freetronics/OLEDSHIELD/OLEDShield.sch

## KiCad design OLEDShield.sch (2013-09-17)

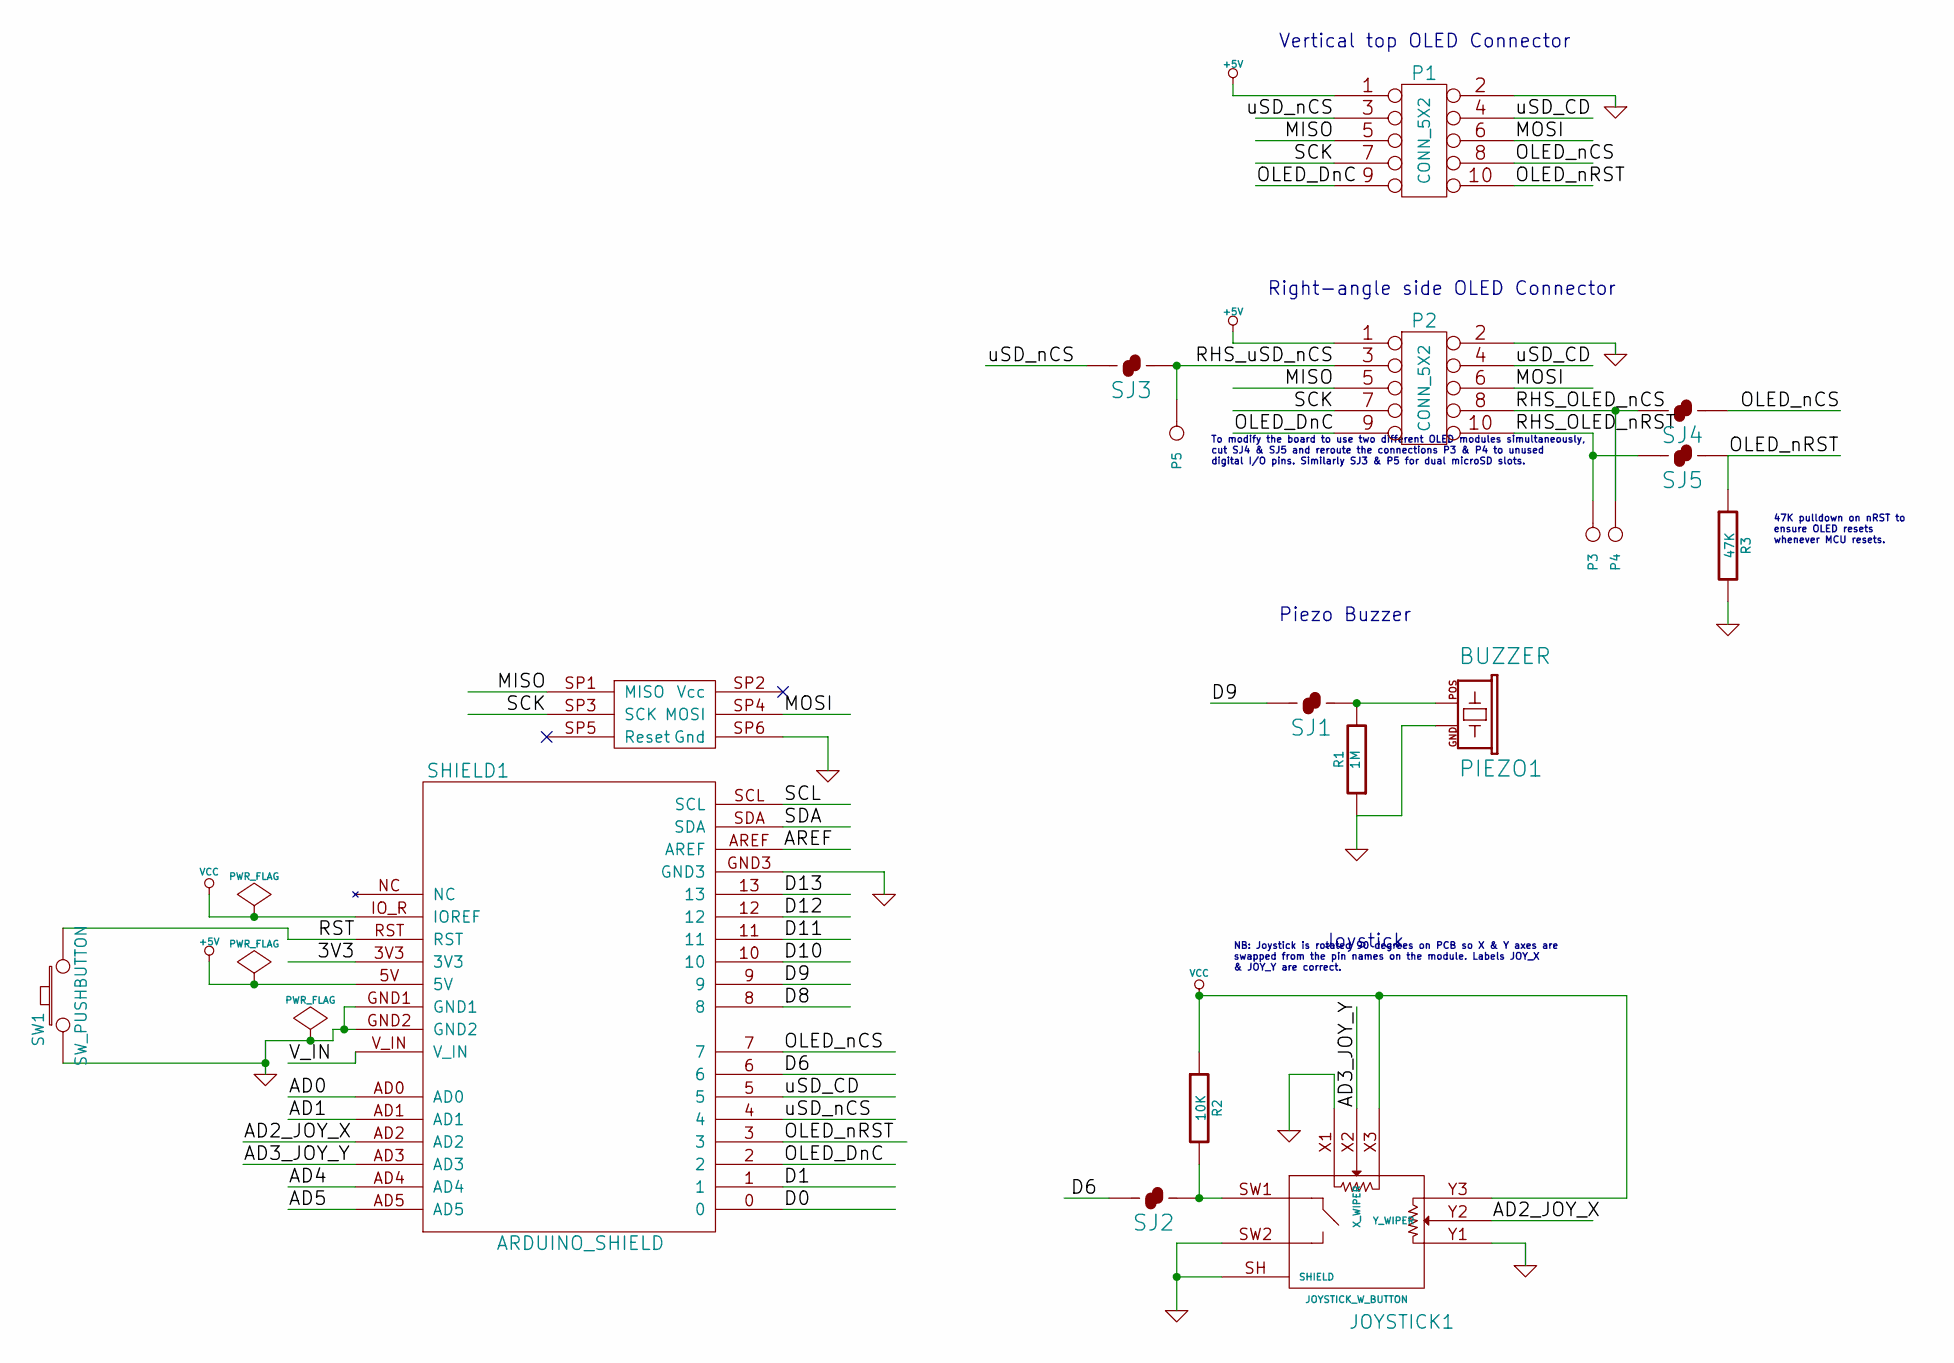
[picture p1: schematic OLEDShield.sch]

Parts:
JOYSTICK1: JOYSTICK_W_BUTTON
P1, P2: CONN_5X2
P3, P4, P5: CONN_1
PIEZO1: BUZZER
R1: 1M
R2: 10K
R3: 47K
SHIELD1: ARDUINO_SHIELD
SJ1, SJ2, SJ3, SJ4, SJ5: SJ
SW1: SW_PUSHBUTTON

Connections:
3V3: SHIELD1.3V3
+5V: P1.1, P2.1, SHIELD1.5V
AD0: SHIELD1.AD0
AD1: SHIELD1.AD1
AD2_JOY_X: JOYSTICK1.Y2 (Y_WIPER), SHIELD1.AD2
AD3_JOY_Y: JOYSTICK1.X2 (X_WIPER), SHIELD1.AD3
AD4: SHIELD1.AD4
AD5: SHIELD1.AD5
AREF: SHIELD1.AREF
D0: SHIELD1.0
D1: SHIELD1.1
D6: SHIELD1.6, SJ2.1
D8: SHIELD1.8
D9: SHIELD1.9, SJ1.1
D10: SHIELD1.10
D11: SHIELD1.11
D12: SHIELD1.12
D13: SHIELD1.13
GND: JOYSTICK1.SH (SHIELD), JOYSTICK1.SW2, JOYSTICK1.X1, JOYSTICK1.Y1, P1.2, P2.2, PIEZO1.2 (GND), R1.1, R3.2, SHIELD1.GND1, SHIELD1.GND2, SHIELD1.GND3, SHIELD1.SP6 (Gnd), SW1.1
MISO: P1.5, P2.5, SHIELD1.SP1 (MISO)
MOSI: P1.6, P2.6, SHIELD1.SP4 (MOSI)
unnamed: JOYSTICK1.SW1, R2.2, SJ2.2
unnamed: PIEZO1.1 (POS), R1.2, SJ1.2
OLED_DnC: P1.9, P2.9, SHIELD1.2
OLED_nCS: P1.8, SHIELD1.7, SJ4.2
OLED_nRST: P1.10, R3.1, SHIELD1.3, SJ5.2
RHS_OLED_nCS: P2.8, P4.1, SJ4.1
RHS_OLED_nRST: P2.10, P3.1, SJ5.1
RHS_uSD_nCS: P2.3, P5.1, SJ3.2
RST: SHIELD1.RST, SW1.2
SCK: P1.7, P2.7, SHIELD1.SP3 (SCK)
SCL: SHIELD1.SCL
SDA: SHIELD1.SDA
VCC: JOYSTICK1.X3, JOYSTICK1.Y3, R2.1, SHIELD1.IO_R (IOREF)
V_IN: SHIELD1.V_IN
uSD_CD: P1.4, P2.4, SHIELD1.5
uSD_nCS: P1.3, SHIELD1.4, SJ3.1

Notes on the sheet:
Vertical top OLED Connector
Right-angle side OLED Connector
Piezo Buzzer
Joystick
To modify the board to use two different OLED modules simultaneously, cut SJ4 & SJ5 and reroute the connections P3 & P4 to unused digital I/O pins. Similarly SJ3 & P5 for dual microSD slots.
NB: Joystick is rotated 90 degrees on PCB so X & Y axes are swapped from the pin names on the module. Labels JOY_X & JOY_Y are correct.
47K pulldown on nRST to ensure OLED resets whenever MCU resets.
