freetronics/OLEDSHIELD/(commit log)

2013-05-29 Schematic done, components placed, no routing yet
    [OLEDShield.kicad_pcb, OLEDShield.sch]
2013-05-31 Board largely done, no silkscreen labels yet
    [OLEDShield.kicad_pcb, OLEDShield.sch]
2013-05-31 Add schematic copyright/license/version info, add schematic PDF
    [OLEDShield.sch]
2013-06-07 Fatten up power traces
    [OLEDShield.kicad_pcb]
2013-06-10 Add power breakout areas, nearly all silkscreening
    [OLEDShield.kicad_pcb, OLEDShield.sch]
2013-06-12 Add ground pour in prototyping area, fix board edges to clear Ethernet jack, finish silkscreening
    [OLEDShield.kicad_pcb, OLEDShield.sch]
2013-06-12 Fix URL, SKU capitalisation
    [OLEDShield.kicad_pcb]
2013-06-21 Widen tracks where they connect to PTH pads
    [OLEDShield.kicad_pcb]
2013-07-18 Reroute board with joystick footprint correctly oriented
    [OLEDShield.kicad_pcb]
2013-07-18 Move piezo from D11 to D9
    [OLEDShield.kicad_pcb, OLEDShield.sch]
2013-07-19 Clean up silkscreen positioning, label formatting
    [OLEDShield.kicad_pcb, OLEDShield.sch]
2013-07-23 Minor cosmetic/silkscreen cleanups
    [OLEDShield.kicad_pcb]
2013-07-24 Add pulldown on nRST to hold OLED in reset during board reset
    [OLEDShield.kicad_pcb, OLEDShield.sch]
2013-07-24 More minor cosmetic cleanup, bump revision to 1.1
    [OLEDShield.kicad_pcb, OLEDShield.sch]
2013-07-24 Regenerate schematic PDF
2013-09-17 Mild cleanup for 1.2 - deepen cutout for Ethernet models, add NC breakout hole, tidy up, swap X axis polarity
    [OLEDShield.kicad_pcb, OLEDShield.sch]
2014-02-04 Grow silkscreen labels where possible, bump version to 1.3
    [OLEDShield.kicad_pcb]
