freetronics/OLEDSHIELD/(notices)

Notices in the files:
OLEDShield.sch:
(C)2013 Freetronics Pty Ltd
Released under TAPR Open Hardware License www.tapr.org/ohl
